SundayRosin/LeadDischargeIndicator/(list of files, drawings)

Other design files:
Board/board12.lay
